stasiselectronics/HotPlateController/README.md

# HotPlateController
A simple ESP32 connected controller for a SMD reflow hot plate
