stasiselectronics/HotPlateController/Hardware Files/Import Files/Silkscreen_Art.png

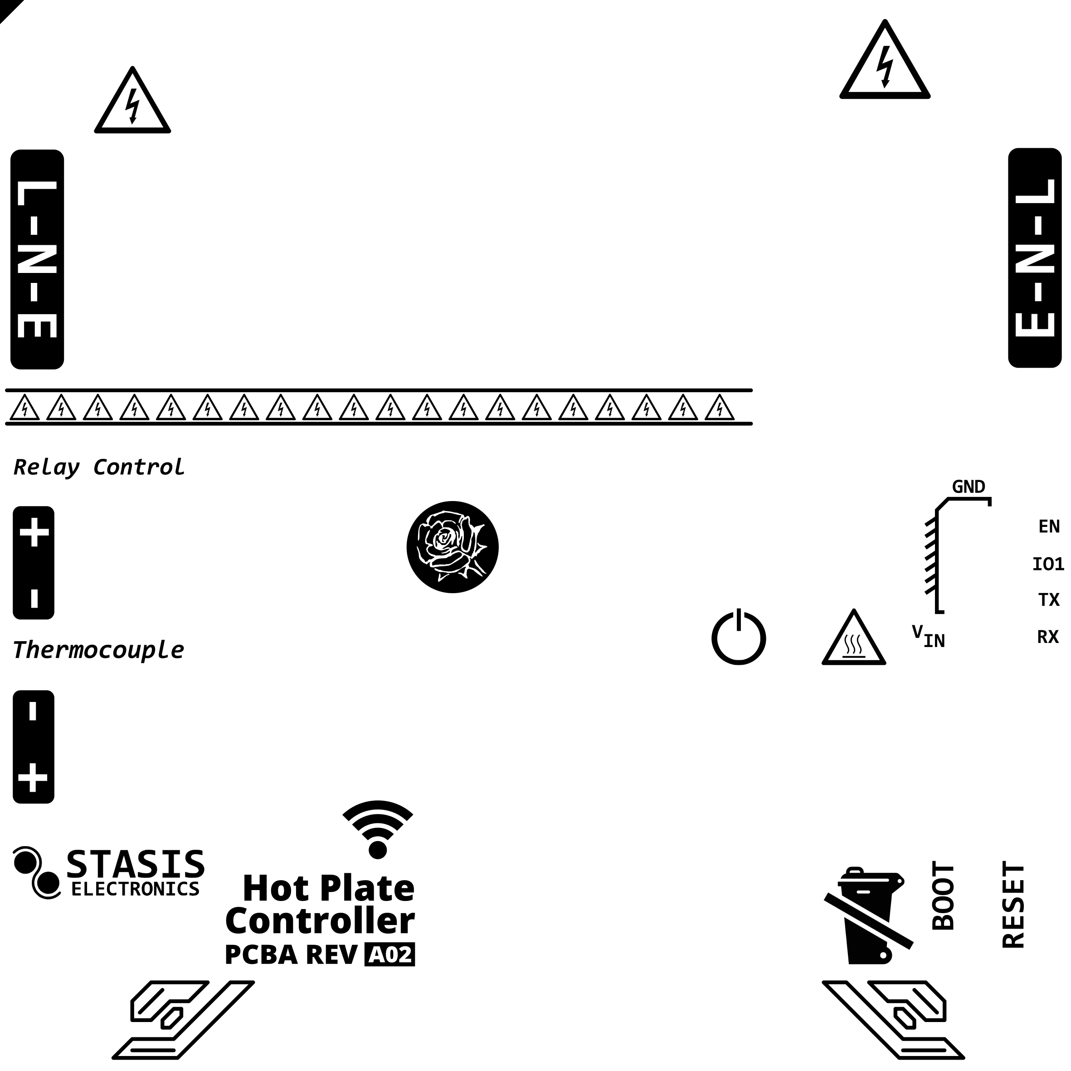
Hardware Files/Import Files/Silkscreen_Art.png
