stasiselectronics/HotPlateController/Hardware Files/Import Files/Silkscreen_Art_Bottom.png

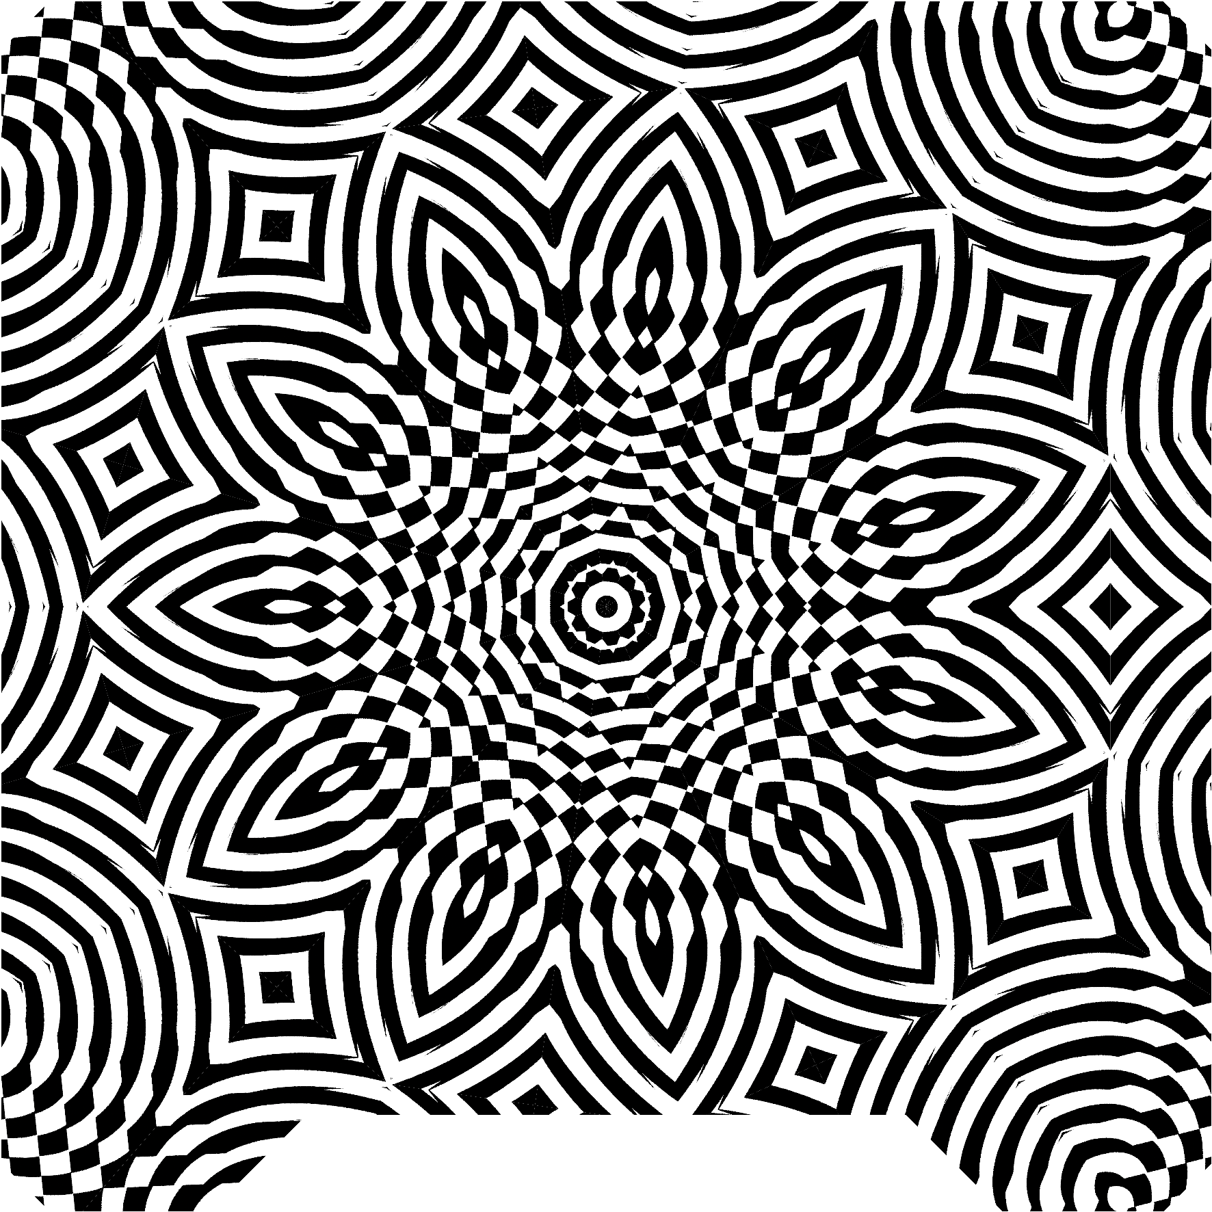
Hardware Files/Import Files/Silkscreen_Art_Bottom.png
