stasiselectronics/HotPlateController/Hardware Files/Assembly Files/HotPlateController_BOM_LCSC.ods

Item | Quantity | Reference | Value | Mf | MPN | OC
1 |  | C10 | 10nF 50V | Yageo | CC1206KRX7R9BB103 | C106239
2 |  | C3 | 10uF 25V 10% | Samsung Electro-Mechanics | CL31B106KAHNNNE | C14860
3 |  | C6 C7 C8 | 1nF 50V | Walsin Technology Corporation | 1206B102K500CT | C396776
4 |  | C4 C5 C9 | 1uF 50V | Yageo | CC1206KKX7R9BB105 | C107185
5 |  | C1 C2 | 220nF 50V | Yageo | CC1206KKX7R9BB224 | C107186
6 |  | D1 | Green 3.0V | EKINGLUX | E6C1206VGAC1UDA | C375461
7 |  | D2 | Orange 2.0V | EKINGLUX | E6Q1206SEAC1UDA | C375584
8 |  | J2 | 0.100" 2x4 Header | XFCN | PZ254V-12-8P | C492421
9 |  | J1 J6 | 1x2 Screw Terminal | Ningbo Kangnex Elec | WJ128V-5.0-2P | C8269
10 |  | J3 J4 | 1x3 Screw Terminal | Pheonix Contact | 1729131 | C91154
11 |  | PS1 | HLK-PM01 5V 3W | HI-LINK | HLK-PM01 | C209903
12 |  | Q1 | NMOS 60V 300mA | Nexperia | 2N7002,215 | C65189
13 |  | Q2 | NMOS 60V 3A | KIA Semicon Tech | KIA4N65HD | C134925
14 |  | R6 R10 | 1206 Jumper 0R | Yageo | RC1206FR-070RL | C137394
15 |  | R9 | 2512 Jumper 0R | Yageo | RC2512JK-070RL | C189505
16 |  | R8 | 43.2R 0.25 1% | Yageo | RC1206FR-0743R2L | C137275
17 |  | R2 R11 R12 R13 R14 | 1.37k 0.25W 1% | Yageo | RC1206FR-071K37L | C488576
18 |  | R1 R4 R5 R7 | 10k 0.25W 5% | Yageo | RC1206JR-0710KL | C136460
19 |  | R3 R15 | 2.67k 0.25W 1% | Yageo | AC1206FR-072K67L | C229517
20 |  | SW1 SW2 | SPST 2 pin tac switch | HYP (Hongyuan Precision) | 1TS002B-2700-5000-CT | C318844
21 |  | U2 | 20A Current Sensor | Allegro MicroSystems, LLC | ACS712ELCTR-20A-T | C10681
22 |  | U3 | ESP32 Wifi Module | Espressif | ESP32-WROOM-32D | C82899
23 |  | U4 | Thermocouple Sensor | Maxim Integrated | MAX31855KASA+T | C52028
24 |  | U1 | 20V Max 3.3V 1A Linear Reg | ON Semiconductor | NCP1117ST33T3G | C26537
