stasiselectronics/HotPlateController/3D Printed Parts/HotPlateController_Assembly.FCStd

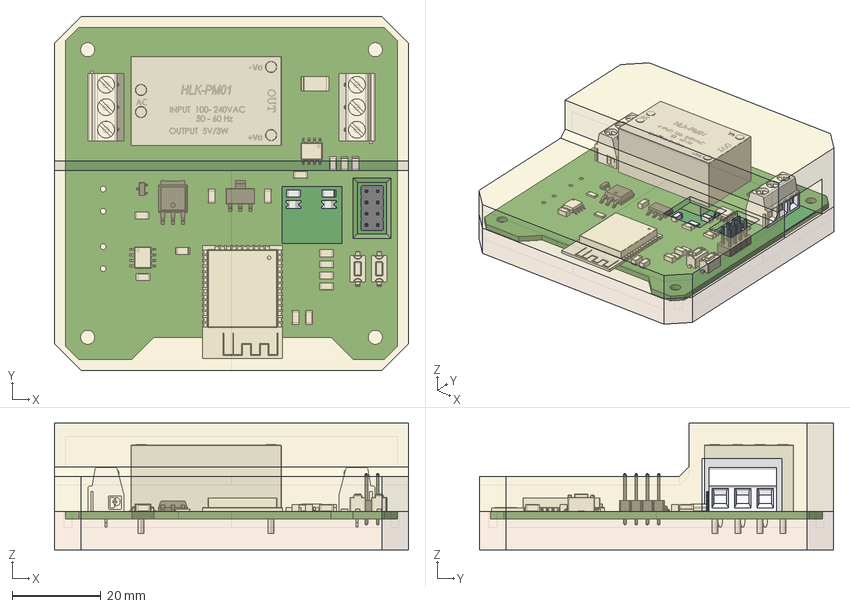
[picture p3: CAD file, 2021-01-22]
3D Printed Parts/HotPlateController_Assembly.FCStd
80.0 x 80.0 x 28.6 mm
