stasiselectronics/HotPlateController/3D Printed Parts/HotPlateController_Base.FCStd

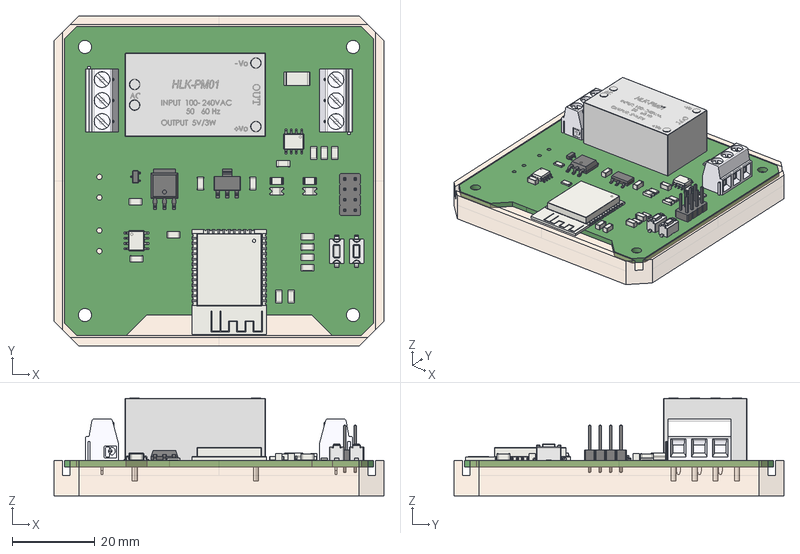
[picture p4: CAD file, 2021-01-22]
3D Printed Parts/HotPlateController_Base.FCStd
80.0 x 80.0 x 23.8 mm
