stasiselectronics/HotPlateController/Hardware Files/Schematics/HotPlateController.pdf

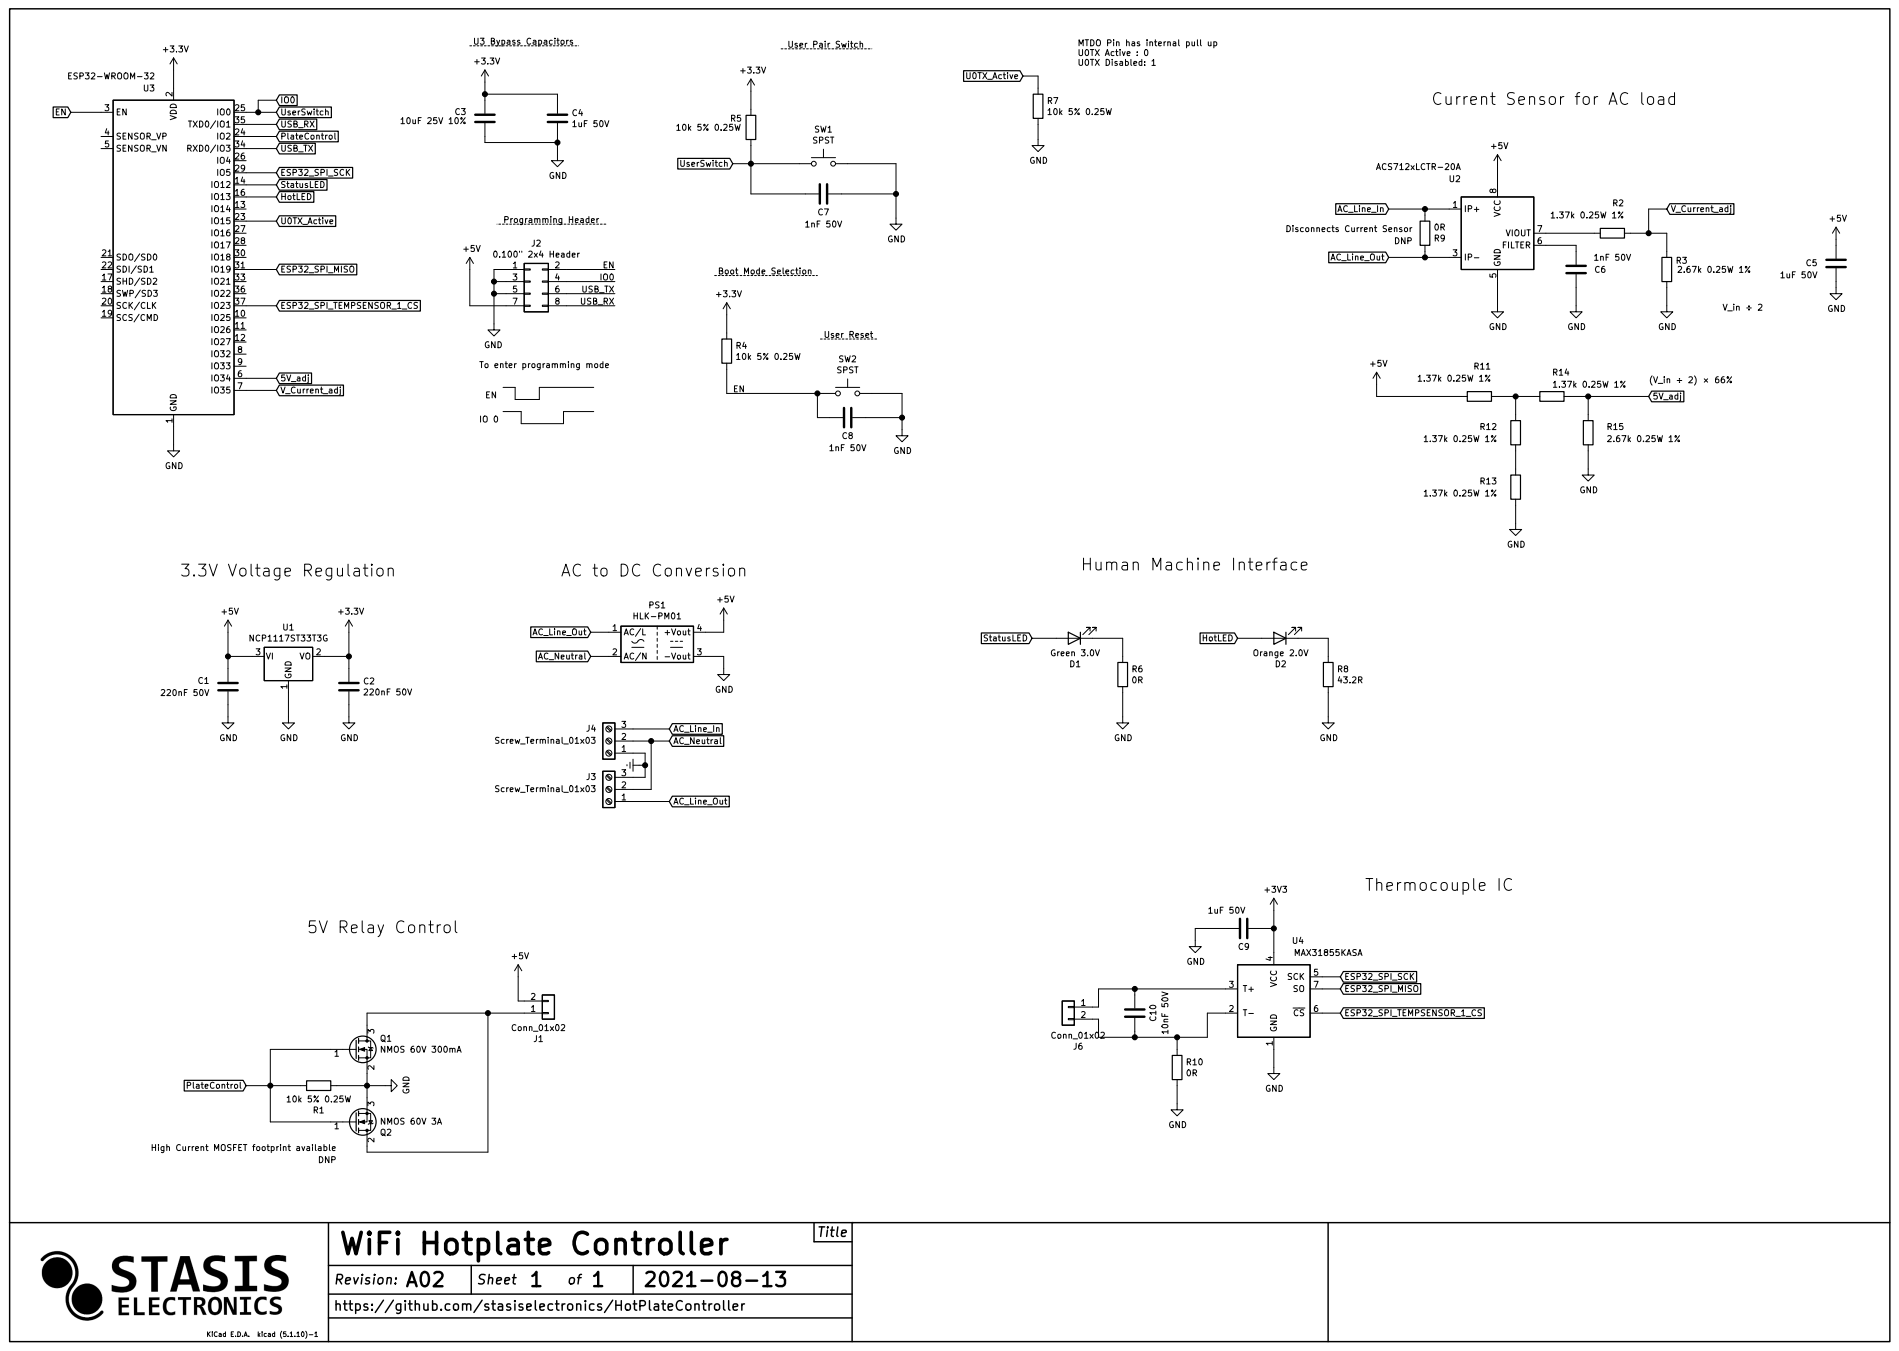
[picture p5: page 1]

U3 Bypass Capacitors
MTDO Pin has internal pull up U0TX Active : 0 U0TX Disabled: 1 To enter programming mode

2 SCK/CLK 20 SDO/SD0 21 SDI/SD1 22

Current Sensor for AC load

5 | IO0 USB_RX USB_TX 6

Boot Mode Selection AC to DC Conversion

High Current MOSFET footprint availableDNP

Title WiFi Hotplate Controller
