stasiselectronics/HotPlateController/Hardware Files/HotPlateController.kicad_pcb

## KiCad design Hardware Files/HotPlateController.kicad_pcb (2021-03-17)

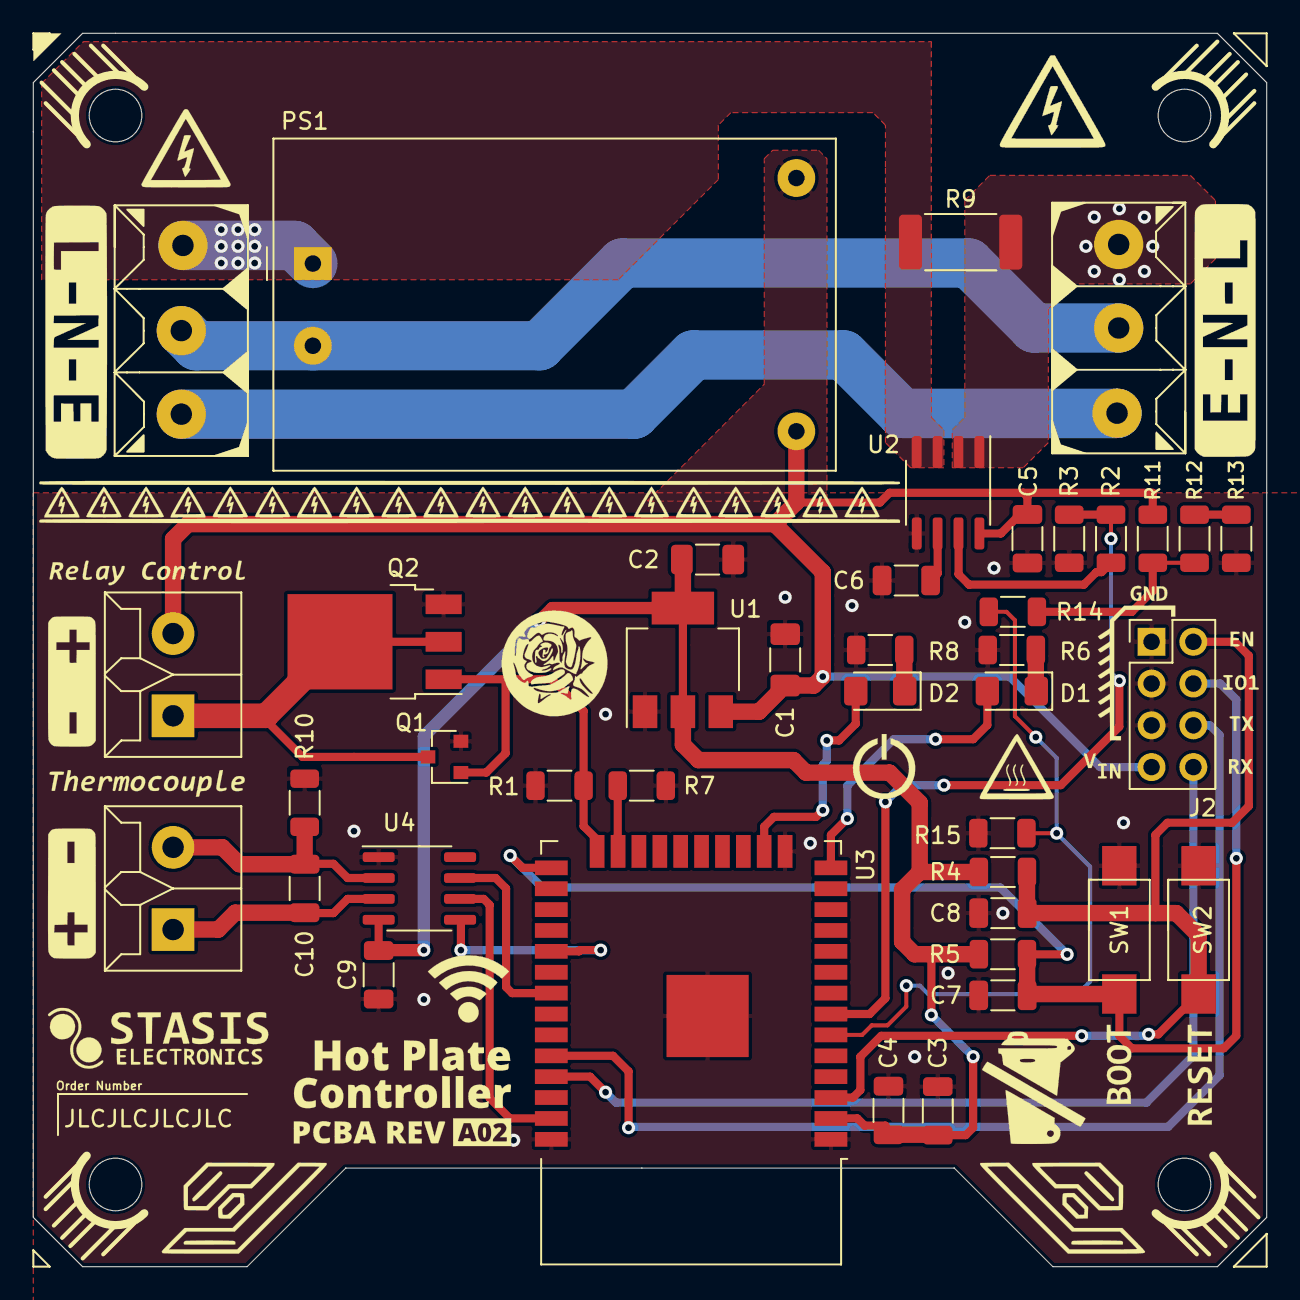
[picture p6: board HotPlateController.kicad_pcb from above]

Board: 2 copper layers, 75.0 x 75.0 mm, 45 parts (0 on the bottom side), 29 nets.

Parts:
C1, C2: 220nF 50V; C_1206_3216Metric_Pad1.33x1.80mm_HandSolder
C3: 10uF 25V 10%; C_1206_3216Metric
C4, C5, C9: 1uF 50V; C_1206_3216Metric
C6, C7, C8: 1nF 50V; C_1206_3216Metric
C10: 10nF 50V; C_1206_3216Metric
D1: Green 3.0V; D_1206_3216Metric_Pad1.42x1.75mm_HandSolder
D2: Orange 2.0V; D_1206_3216Metric_Pad1.42x1.75mm_HandSolder
J1, J6: Conn_01x02; 1935161
J2: 0.100" 2x4 Header; PinHeader_2x04_P2.54mm_Vertical
J3, J4: Screw_Terminal_01x03; 1729131
M1, M2, M3, M4: Conn_01x01; MountingHole_3.2mm_M3_DIN965
PS1: HLK-PM01; Converter_ACDC_HiLink_HLK-PMxx
Q1: NMOS 60V 300mA; SOT-23
Q2: NMOS 60V 3A; TO-252-3_TabPin2
R1, R4, R5, R7: 10k 5% 0.25W; R_1206_3216Metric
R2, R11, R12, R13, R14: 1.37k 0.25W 1%; R_1206_3216Metric
R3, R15: 2.67k 0.25W 1%; R_1206_3216Metric
R6, R10: 0R; R_1206_3216Metric
R8: 43.2R; R_1206_3216Metric
R9: 0R; R_2512_6332Metric_Pad1.40x3.35mm_HandSolder
SW1, SW2: SPST; PTS636_SM25F_SMTR_LFS
U1: NCP1117ST33T3G; SOT-223-3_TabPin2
U2: ACS712xLCTR-20A; SOIC-8_3.9x4.9mm_P1.27mm
U3: ESP32-WROOM-32
U4: MAX31855KASA; SOIC-8_3.9x4.9mm_P1.27mm

Connections:
5V_adj: R14.2, R15.1, U3.6
+3V3: C2.1, C3.2, C4.1, C9.1, R4.1, R5.1, U1.2, U3.2, U4.4
+5V: C1.1, C5.2, J1.2, J2.7, PS1.4, R11.1, U1.3, U2.8
AC_Line_In: J4.3, R9.2, U2.1, U2.2
AC_Line_Out: J3.1, PS1.1, R9.1, U2.3, U2.4
AC_Neutral: J3.2, J4.2, PS1.2
EN: C8.2, J2.2, R4.2, SW2.1, U3.3
ESP32_SPI_MISO: U3.31, U4.7
ESP32_SPI_SCK: U3.29, U4.5
ESP32_SPI_TEMPSENSOR_1_CS: U3.37, U4.6
Earth: J3.3, J4.1
GND: C1.2, C2.2, C3.1, C4.2, C5.1, C6.2, C7.1, C8.1, C9.2, J2.1, J2.3, J2.5, PS1.3, Q1.2, Q2.3, R1.1, R3.2, R6.2, R7.2, R8.2, R10.2, R13.2, R15.2, SW1.2, SW2.2, U1.1, U2.5, U3.1, U3.15, U3.38, U3.39, U4.1
HotLED: D2.2, U3.16
IO0: C7.2, J2.4, R5.2, SW1.1, U3.25
unnamed: C6.1, U2.6
unnamed: C10.1, J6.1, U4.3
unnamed: C10.2, J6.2, R10.1, U4.2
unnamed: D1.1, R6.1
unnamed: D2.1, R8.1
unnamed: J1.1, Q1.3, Q2.2
unnamed: R2.1, U2.7
unnamed: R11.2, R12.1, R14.1
unnamed: R12.2, R13.1
PlateControl: Q1.1, Q2.1, R1.2, U3.24
StatusLED: D1.2, U3.14
U0TX_Active: R7.1, U3.23
USB_RX: J2.8, U3.35
USB_TX: J2.6, U3.34
V_Current_adj: R2.2, R3.1, U3.7
