stasiselectronics/HotPlateController/Hardware Files/Assembly Files/Wiring Diagram.png

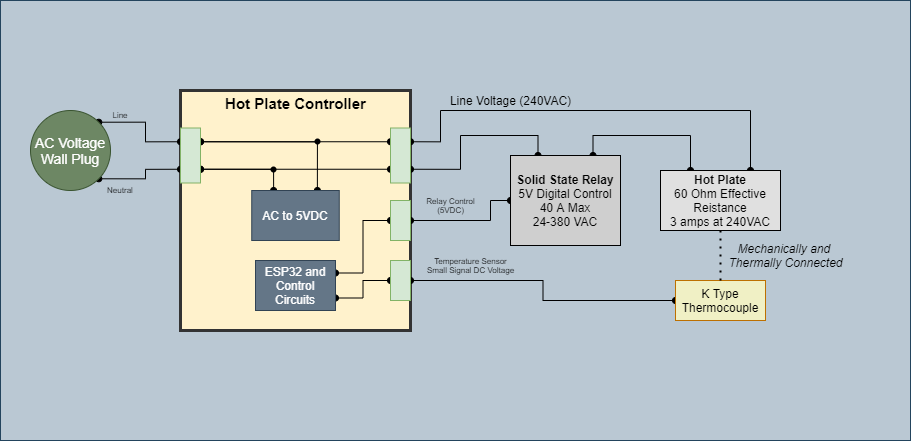
Hardware Files/Assembly Files/Wiring Diagram.png
