stasiselectronics/HotPlateController/Firmware Files/HotPlateController_mqttFirmware/WifiProvisioning.ino

// this code is to show how to provision an ESP32 onto a wifi network
// use it to easily flash code and configure the device over serial

// This code is built around the Stasis Electronics Hot Plate Controller
// an esp32 controller for SMD reflow



                                            
// Starting off with libraries to include
// TODO: add information on how to install new libriaries

#include <WiFi.h>
#include <EEPROM.h>

// Settings
#define EEPROM_SIZE 512 // total memory in bytes we can save and read
#define BAUD_RATE 115200 // for serial communication
#define BUFFSIZE 64 // size of a common char array buffer size
#define TOTAL_MEMORY 512
#define RESPONSE_TIMEOUT 60000 // one minute in ms

// Global Objects
extern char mySSID[BUFFSIZE];
extern char myPassword[BUFFSIZE];
extern char myMQTTServer[BUFFSIZE];

unsigned int readNetworkInfo(){
  unsigned int checksum = 0;
  for(int i = 0; i < 64; i++){
    mySSID[i]=(char)EEPROM.read(i);
    myPassword[i]=(char)EEPROM.read(i+64);
    myMQTTServer[i]=(char)EEPROM.read(i+128);
    checksum+=(byte)mySSID[i] + (byte)myPassword[i] + (byte)myMQTTServer[i];
  }
  return checksum;
}

unsigned int saveNetworkInfo(){
  unsigned int checksum = 0;
  for(int i = 0; i < 64; i++){
    EEPROM.write(i, mySSID[i]);
    EEPROM.write(i+64, myPassword[i]);
    EEPROM.write(i+128, myMQTTServer[i]);
    checksum+=(byte)mySSID[i] + (byte)myPassword[i] + (byte)myMQTTServer[i];
  }
  EEPROM.commit();
  return checksum;
}

void WiFiProvision() {
  // Setup Memory
  EEPROM.begin(EEPROM_SIZE);
  String response = "";
  Serial.println("Checking for existing network credentials");
  if(readNetworkInfo()){
    // there are existing crednetials, lets try those 
    Serial.println("Credentials found:");
    Serial.println(mySSID);
    Serial.println(myPassword);
    Serial.print("MQTT Server: ");Serial.println(myMQTTServer);
    Serial.print("Checksum:  ");Serial.println(readNetworkInfo());
    Serial.println("Let's try connecting to that one");
  }
  else{
    Serial.println("Going to go check what WiFi Networks are there...\n");
    int number_of_networks = WiFi.scanNetworks();
    if (number_of_networks == 0) {
      Serial.println("Oh dear! No networks found...");
      // TODO: add error handling
    }
    else{
      Serial.println("There are " + (String) number_of_networks + " networks available to connect to");
      Serial.flush();
      delay(10);
      for (int i = 0; i < number_of_networks; ++i) {
        // Print SSID and RSSI for each network found
        Serial.print(i+1); Serial.print(" : ");
        String mySSID = WiFi.SSID(i);
        Serial.print(mySSID);
        Serial.print('\n');
        Serial.flush();
        delay(3);
      }
      // ask which one to connect to
      Serial.println("What's the SSID you want to connect to? Enter its number and press enter");
      Serial.println("If nothing happens, make sure you are appending a line feed to your input");
      response = readstring(RESPONSE_TIMEOUT);
      if(response == "Timeout"){
        Serial.println("Input timeout, restart to try again");
        while(true){
          int i = rand()*100;
        }
      }
      response.toCharArray(mySSID, BUFFSIZE);
      Serial.println("Connecting to " + (String)mySSID);
      Serial.println("What's the password?");
      response = readstring(RESPONSE_TIMEOUT);
      response.toCharArray(myPassword, BUFFSIZE);

      Serial.println("What is the MQTT Server's ip address?");
      response = readstring(RESPONSE_TIMEOUT);
      response.toCharArray(myMQTTServer, BUFFSIZE);
    }
  }
  // Either we loaded credentials or we asked for new ones
  // ready to try and connect
  Serial.println("Attempting to connect");
  WiFi.begin((char*)mySSID, (char*)myPassword);
  unsigned long start_time = millis();
  while(WiFi.status() != WL_CONNECTED) {
    unsigned long current_time = millis();
    if(current_time-start_time>=1000) {
      Serial.print("\u2592"); // Print a block ▒
      start_time=current_time;
    }
  }
  Serial.println("\n\nDevice connected successfully!");
  Serial.print("IPv4 Address:  ");Serial.println(WiFi.localIP());

  Serial.println("Saving credentials");
  Serial.print("Checksum:  ");Serial.println(saveNetworkInfo());
  
}
