stasiselectronics/HotPlateController/(commit log)

2021-01-11 Update schematic
    [HotPlateController.sch]
2021-01-11 add voltage regulator
    [HotPlateController.sch]
2021-01-11 update ACS712 Circuit
    [HotPlateController.sch]
2021-01-11 Fix footprints
    [HotPlateController.kicad_pcb, HotPlateController.sch]
2021-01-11 Add Relay level shifter
    [HotPlateController.kicad_pcb, HotPlateController.sch]
2021-01-11 Begin Layout
    [HotPlateController.kicad_pcb, HotPlateController.sch]
2021-01-11 add 3 pos terminal footprint
    [HotPlateController.kicad_pcb, HotPlateController.sch]
2021-01-11 Bulk routing
    [HotPlateController.kicad_pcb, HotPlateController.sch]
2021-01-12 Add artwork update PCBA Rev Silkscreen
    [HotPlateController.kicad_pcb]
2021-01-12 update item details
    [HotPlateController.sch]
2021-01-12 Update Part Ordering Information
    [HotPlateController.kicad_pcb, HotPlateController.sch]
2021-01-13 Finalize board layout and art
    [HotPlateController.kicad_pcb, HotPlateController.sch]
2021-01-13 Finalize A01 Design
    [HotPlateController.kicad_pcb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]
2021-01-13 Fix gerber output
    [HotPlateController-B_Cu.gbr, HotPlateController-B_Mask.gbr, HotPlateController-B_SilkS.gbr, HotPlateController-Edge_Cuts.gbr, HotPlateController-F_Cu.gbr, HotPlateController-F_Mask.gbr, HotPlateController-F_Paste.gbr, HotPlateController-F_SilkS.gbr]
2021-01-13 add jlcpcb order number location
    [HotPlateController-B_Cu.gbr, HotPlateController-B_Mask.gbr, HotPlateController-B_SilkS.gbr, HotPlateController-Edge_Cuts.gbr, HotPlateController-F_Cu.gbr, HotPlateController-F_Mask.gbr, HotPlateController-F_Paste.gbr, HotPlateController-F_SilkS.gbr]
2021-01-13 add jlcpcb ordering number
    [HotPlateController.kicad_pcb]
2021-01-22 Add 3D model
    [HotPlateController_Base.FCStd]
2021-02-03 Fix missing hot plate control trace
    [HotPlateController.kicad_pcb, HotPlateController.sch]
2021-02-03 update Thermocouple pin assignments
    [HotPlateController.sch]
2021-02-03 Reroute Thermocouple IC traces
    [HotPlateController.kicad_pcb]
2021-02-19 Fix Thermocouple layout adjust pinouts to fix GPIO Issues adjust schematic formatting
    [HotPlateController.kicad_pcb, HotPlateController.sch]
2021-02-21 add 5v sense circuit Move around components Adjust board shape
    [HotPlateController.kicad_pcb, HotPlateController.sch]
2021-02-21 Finalize Layout Finalize Artwork Finalize Schematic
    [HotPlateController.kicad_pcb, HotPlateController.sch]
2021-03-16 add bottom artwork add part info to missing 10nF cap update BOM
    [HotPlateController.kicad_pcb, HotPlateController.sch]
2021-03-17 Generate A02 Board Fab Files
    [HotPlateController-B_Cu.gbr, HotPlateController-B_Mask.gbr, HotPlateController-B_SilkS.gbr, HotPlateController-Edge_Cuts.gbr, HotPlateController-F_Cu.gbr, HotPlateController-F_Mask.gbr, HotPlateController-F_Paste.gbr, HotPlateController-F_SilkS.gbr]
2021-04-10 Add BOM for A02 version
    [HotPlateController_BOM_LCSC.ods]
2021-04-11 A02 Assembly updates to check signals
2021-04-11 add led on wifi connect
2021-04-24 add wiring diagram
2021-05-01 Add interrupt based timers for non blocking LED blinking
2021-07-27 Add PID firmware
2021-08-13 add pdf schematic
2021-08-13 update schematic titleblock
    [HotPlateController.sch]
